relientm96/unoAudioBoard/schematics.pdf

# Micro-Controller Input Stage

## Button Effect Select

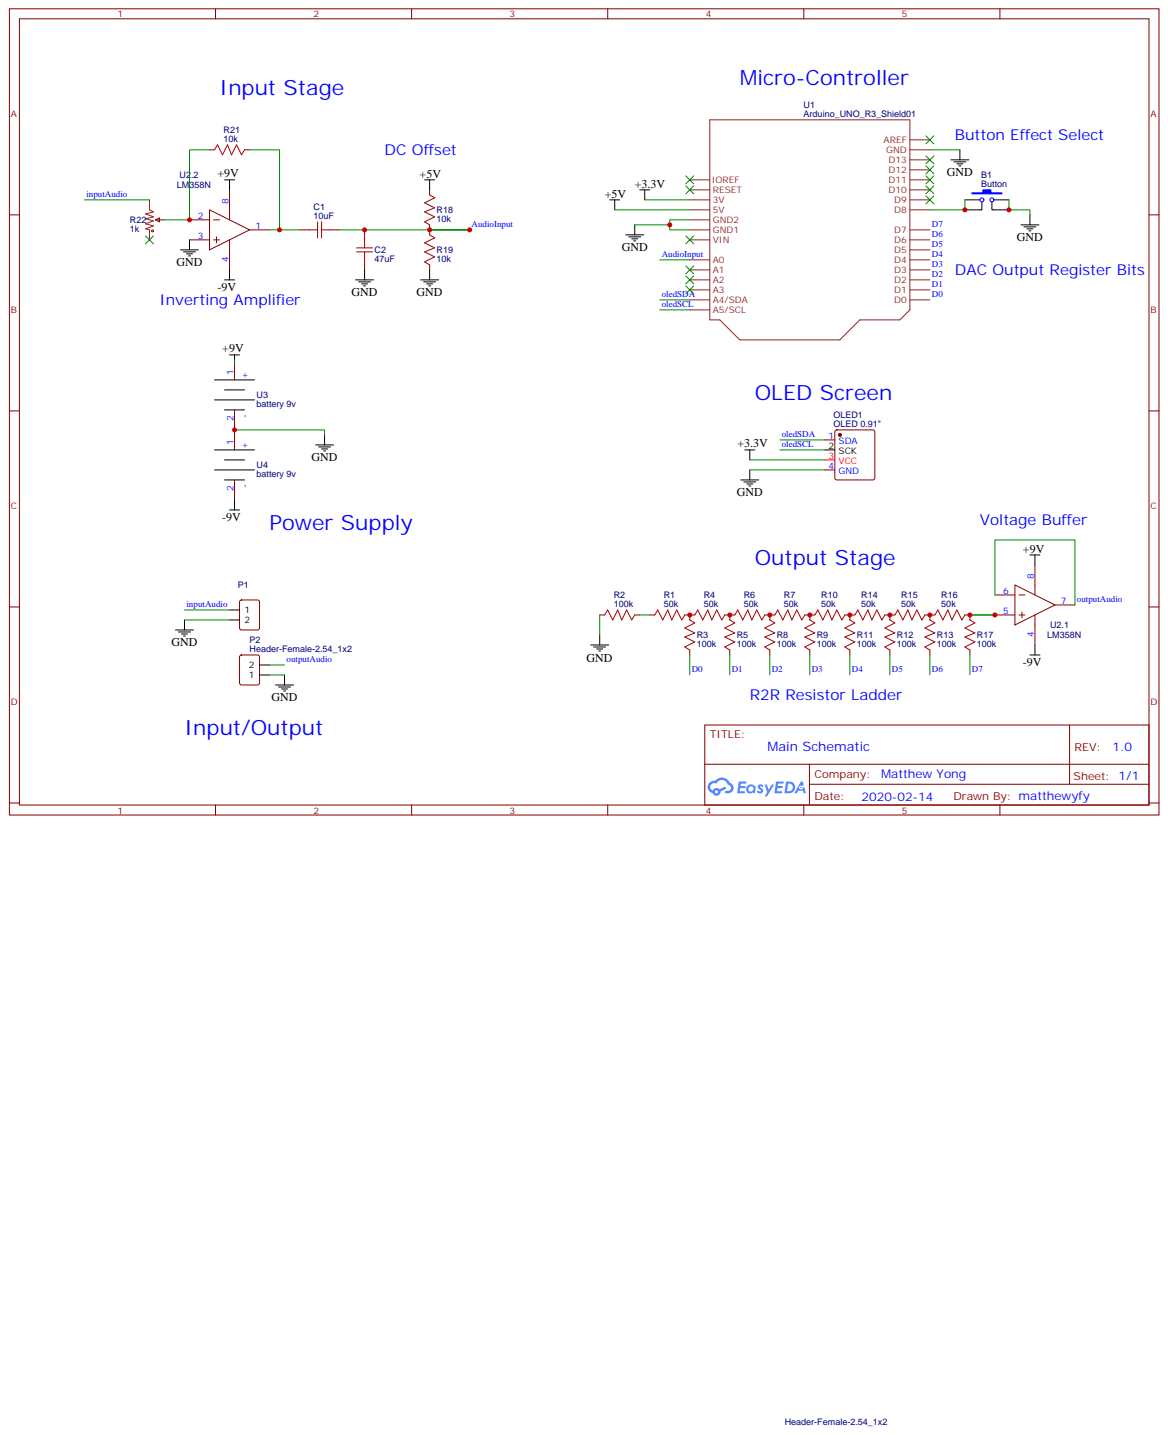
[picture p3: page 1]
