relientm96/unoAudioBoard/arduinoFastAudio/modulate.h

// Sine Lookup Table of 1023 values

const byte waveform[] PROGMEM = {
128,128,129,130,131,131,132,133,134,135,
135,136,137,138,138,139,140,141,142,142,
143,144,145,145,146,147,148,149,149,150,
151,152,152,153,154,155,155,156,157,158,
159,159,160,161,162,162,163,164,165,165,
166,167,168,168,169,170,170,171,172,173,
173,174,175,176,176,177,178,178,179,180,
181,181,182,183,183,184,185,186,186,187,
188,188,189,190,190,191,192,192,193,194,
194,195,196,196,197,198,198,199,200,200,
201,202,202,203,204,204,205,205,206,207,
207,208,208,209,210,210,211,211,212,213,
213,214,214,215,215,216,217,217,218,218,
219,219,220,220,221,222,222,223,223,224,
224,225,225,226,226,227,227,228,228,229,
229,230,230,230,231,231,232,232,233,233,
234,234,234,235,235,236,236,237,237,237,
238,238,239,239,239,240,240,240,241,241,
241,242,242,242,243,243,243,244,244,244,
245,245,245,246,246,246,247,247,247,247,
248,248,248,248,249,249,249,249,250,250,
250,250,250,251,251,251,251,251,252,252,
252,252,252,252,253,253,253,253,253,253,
253,254,254,254,254,254,254,254,254,254,
254,254,255,255,255,255,255,255,255,255,
255,255,255,255,255,255,255,255,255,255,
255,255,255,255,255,255,255,255,255,255,
255,254,254,254,254,254,254,254,254,254,
254,253,253,253,253,253,253,253,253,252,
252,252,252,252,251,251,251,251,251,251,
250,250,250,250,249,249,249,249,248,248,
248,248,247,247,247,247,246,246,246,245,
245,245,245,244,244,244,243,243,243,242,
242,242,241,241,241,240,240,239,239,239,
238,238,238,237,237,236,236,235,235,235,
234,234,233,233,232,232,232,231,231,230,
230,229,229,228,228,227,227,226,226,225,
225,224,224,223,223,222,222,221,221,220,
220,219,219,218,217,217,216,216,215,215,
214,213,213,212,212,211,211,210,209,209,
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
};
